Sparify/Carybot/LaTex/Pictures/carybot.png

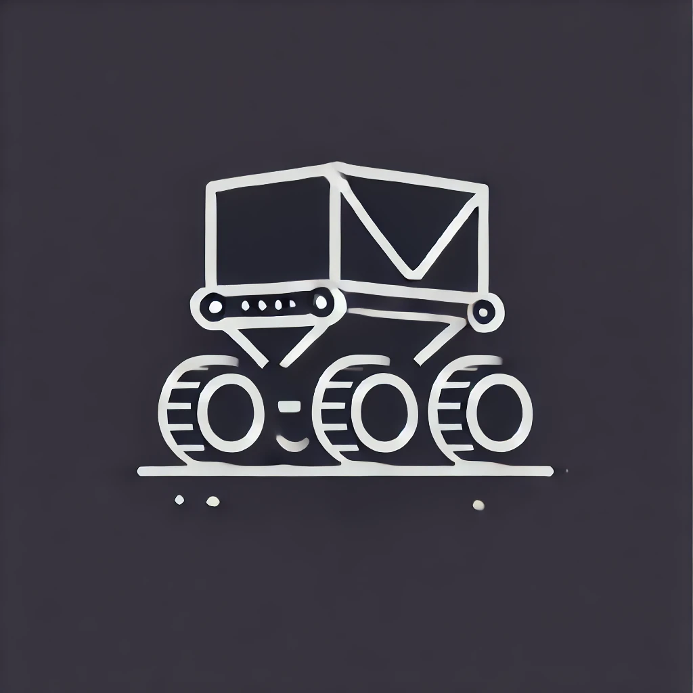
LaTex/Pictures/carybot.png
