Sparify/Carybot/LaTex/Pictures/Projekt-Grobplan.jpg

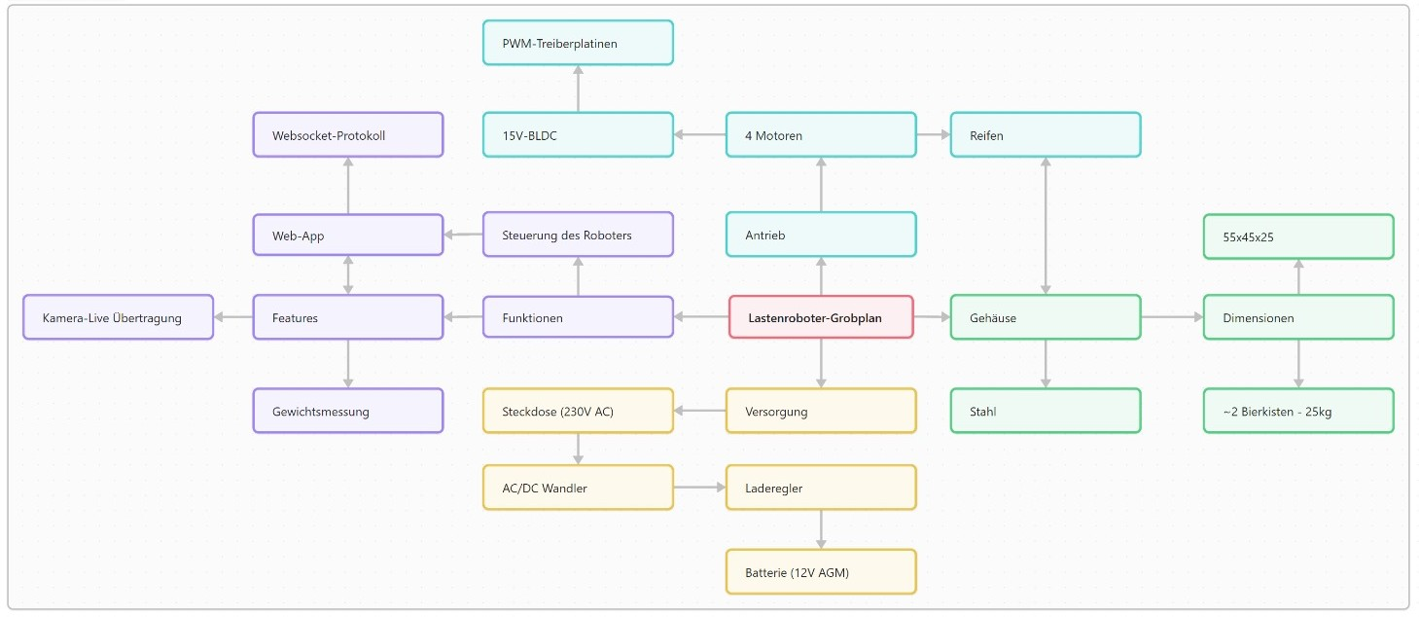
LaTex/Pictures/Projekt-Grobplan.jpg
