Sparify/Carybot/LaTex/Pictures/Schaltplan-Steuerplatine.png

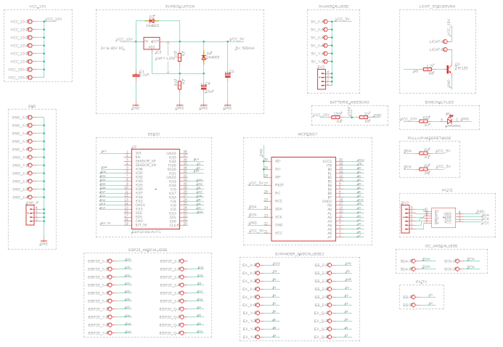
LaTex/Pictures/Schaltplan-Steuerplatine.png
