Sparify/Carybot/(list of files, cad)

Other CAD files:
3D-Design/Gehäuse_echtewerte.f3d
3D-Design/Kamera_arm-neu.f3d
3D-Design/Reifenhalterung v2.f3z
