Sparify/Carybot/LaTex/Pictures/Steuerplatine.pdf

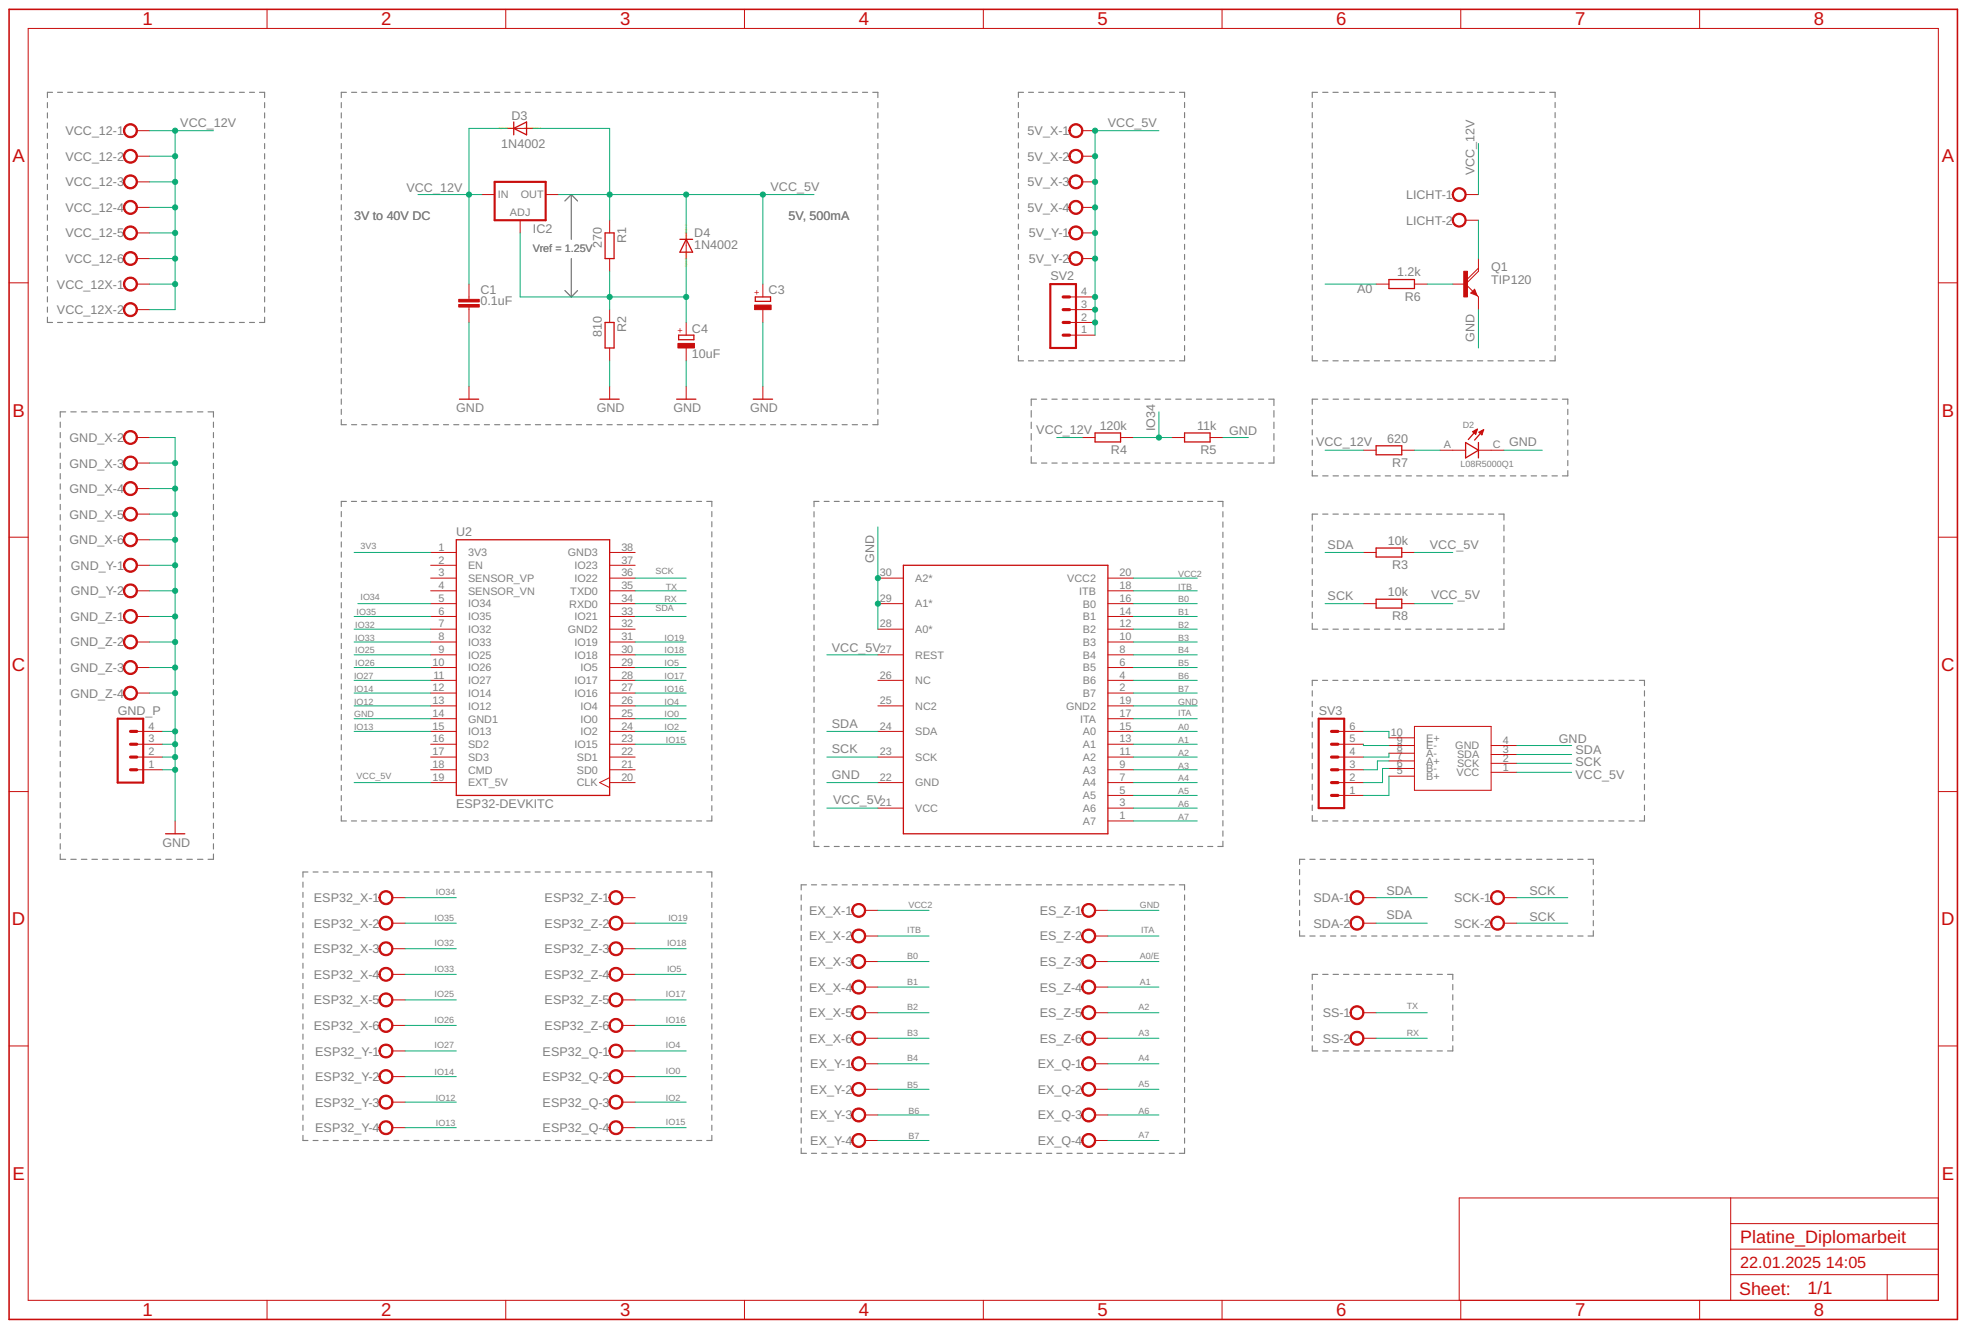
[picture p182: page 1]
