Sparify/Carybot/Platine/PCB/Platine_Diplomarbeit.brd

## EAGLE design Platine/PCB/Platine_Diplomarbeit.brd (2025-01-16)

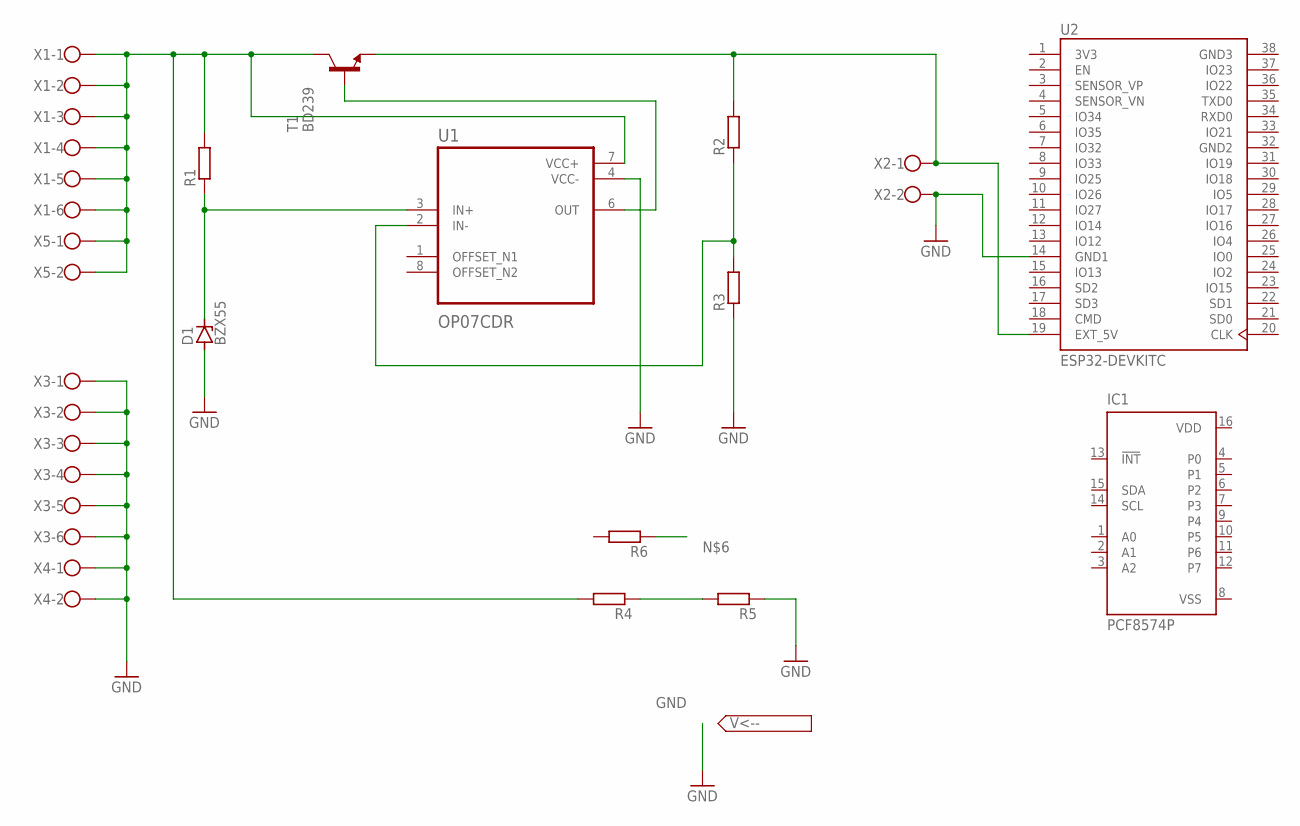
[picture p183: schematic Platine_Diplomarbeit.sch]

Parts:
D1: BZX55; DO35Z10
IC1: PCF8574P; DIL16
R1, R2, R3, R4, R5, R6: R-EU_0309/12; 0309/12
T1: BD239; TO220
U1: OP07CDR; SOIC127P599X175-8N
U2: ESP32-DEVKITC; MODULE_ESP32-DEVKITC
X1, X3: W237-6
X2, X4, X5: W237-102

Connections:
3V3: U2.1 (3V3)
GND: D1.A, R3.1, R5.1, U1.4 (VCC-), U2.14 (GND1), X2.2, X3.1, X3.2, X3.3, X3.4, X3.5, X3.6, X4.1, X4.2
GND1: R1.2, R4.2, T1.2 (C), U1.7 (VCC+), X1.1, X1.2, X1.3, X1.4, X1.5, X1.6, X5.1, X5.2
GND2: U2.32 (GND2)
GND3: U2.38 (GND3)
unnamed: D1.C, R1.1, U1.3 (IN+)
unnamed: R4.1, R5.2
unnamed: R2.2, T1.3 (E), U2.19 (EXT_5V), X2.1
unnamed: R2.1, R3.2, U1.2 (IN-)
unnamed: T1.1 (B), U1.6 (OUT)
VDD: IC1.16 (VDD)
VSS: IC1.8 (VSS)

Board: 2 copper layers, 16 parts (0 on the bottom side), 7 nets, no tracks yet.
