Sparify/Carybot/(commit log)

2024-11-07 steuerung für 2 motoren
2024-11-13 camera buttons + menu
2024-12-19 Adding anti select + fixing cam control
    [main.cpp]
2024-12-28 Steuerung für 4 Motoren
2025-01-27 motorsteuerung implementieren
2025-01-30 camera control as slider
2025-01-30 fix servo
2025-02-21 eidesstattliche erklaerung
    nach dem vorbild des bildungsministeriums
2025-02-21 paket fuer namen in fusszeile eingefuegt und als muster benutzt
2025-02-26 Motoren gefixt
2025-03-02 projektteam und meilensteine hinzugefuegt
    latex is einfach beschte
2025-03-02 upload content
    -Steuerkreuz
    -Geschwindigkeitseinstellung
    -Kamerasteuerung
    -Echtzeit-Videoanzeige
    -Sensordaten
    -Verbindungsstatus
2025-03-08 Kleinen Fehler bei Latex datei gefixt und bei main.cpp unötige Kommentare entfernt
2025-03-10 motoren_code fertiggestellt
2025-03-12 fix wir
2025-03-12 Sensoren_hcsr04_hinzugefügt
2025-03-15 sensoren gewichtsmessung hinzugefügt
2025-03-17 Realisierung + Materialliste
2025-03-19 esp32 inhalt hinzugefügt
2025-03-19 sg90 servomotor inhalt hinzugefügt
2025-03-20 schavi - servo
2025-03-29 servo inhalt fertiggestellt
2025-03-30 erweiterung des gehäuses
2025-04-03 stop jetzt aber wirklich (Spielzeug)
2025-04-12 kamera gefixt und gewicht in kg
